JeffB-BE/Morse-CPO/README.md

# Morse-CPO
Twin-T Oscillator design based upon the work by Michael A. Maynard (K4ICY).
