JeffB-BE/Morse-CPO/KiCad/Twin-T_Code_Practice_Oscillator/img/Twin-T_Code_Practice_Oscillator_PCB-1.png

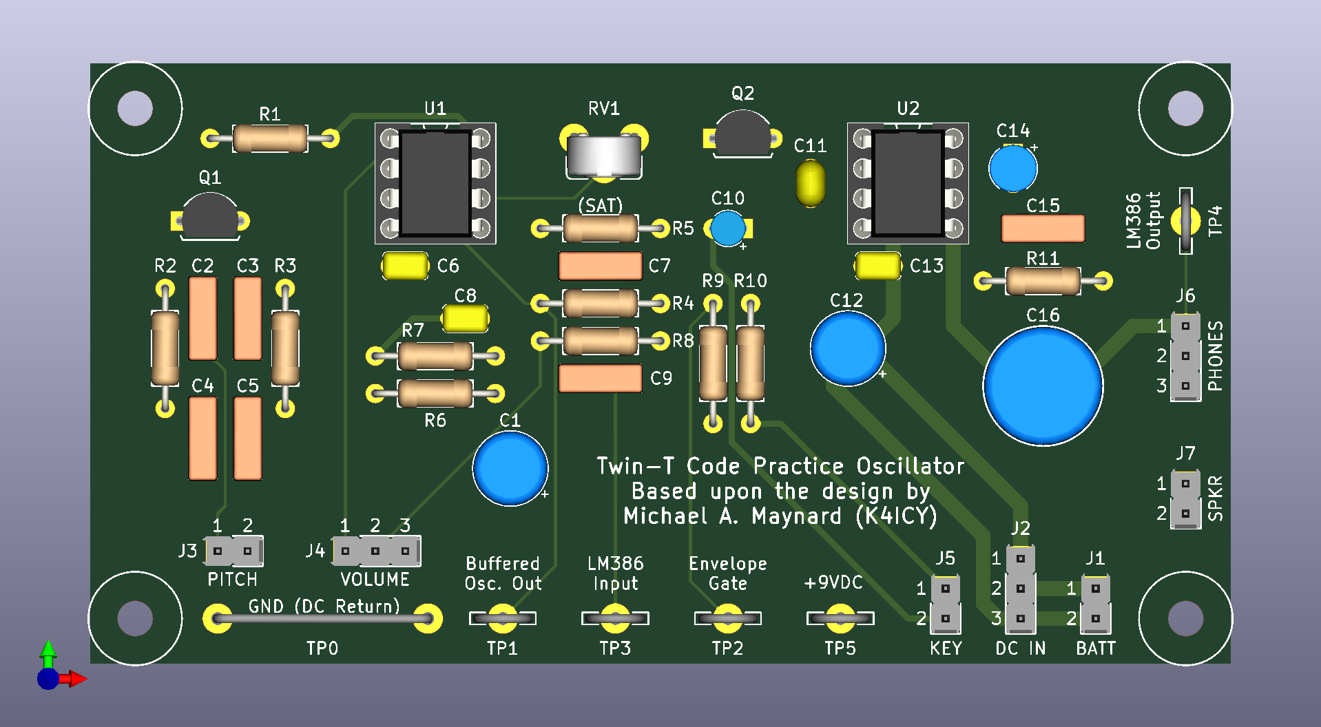
KiCad/Twin-T_Code_Practice_Oscillator/img/Twin-T_Code_Practice_Oscillator_PCB-1.png
