JeffB-BE/Morse-CPO/Twin-T_Code_Practice_Oscillator_Rev(A)_SystemBOM.xlsx

Sheet: PCB
Item | Qty | References | Value | Lead Spacing | Type | Mfrg. | Manufacturer P/N | Distributor | Dist. P/N | Status | Datasheet
1 | 1 | C11 | 47p | 100mil (2.5mm) | MLCC, C0G | Vishay-Sprague | 1C10C0G470J050B | Mouser | 75-1C10C0G470J050B |  | https://www.mouser.com/datasheet/2/427/Sprague%201C-3C%20MLC%20leaded%20capacitors%202000-1211470.pdf
2 | 3 | C6, C8, C13 | 100n | 100mil (2.5mm) | MLCC, X7R | Vishay | K103K15X7RF53L2 | Mouser | 594-K103K15X7RF53L2 |  | https://www.vishay.com/docs/45171/kseries.pdf
3 | 4 | C2, C3, C4, C5 | 10n | 200 mil (5mm) | Polyester Film | Kemet | MMK5103J63J01L16.5 | Mouser | 80-MMK5103J63J01TR18 |  | https://content.kemet.com/datasheets/F3294_MMK.pdf
4 | 1 | C7 | 47n | 200 mil (5mm) | Polyester Film | Kemet | MMK5473J63J01L4 | Mouser | 80-MMK5473J63J01L4 |  | https://content.kemet.com/datasheets/F3294_MMK.pdf
5 | 1 | C9 | 15n | 200 mil (5mm) | Polyester Film | Kemet | MMK5153J63J01L16.5 | Mouser | 80-MMK5153J63J01TR16 |  | https://content.kemet.com/datasheets/F3294_MMK.pdf
6 | 1 | C15 | 100n | 200 mil (5mm) | Polyester Film | Kemet | MMK5104J63J01L4 | Mouser | 80-MMK5104J63J01L4 |  | https://content.kemet.com/datasheets/F3294_MMK.pdf
7 | 1 | C16 | 220u | 200 mil (5mm) | Non-Polarized Electrolytic | Panasonic | ECE-A1CN221XB | Mouser | 667-ECE-A1CN221XB |  | https://industrial.panasonic.com/cdbs/www-data/pdf/RDF0000/ABA0000C1053.pdf
8 | 1 | C10 | 4u7 | 100mil (2.5mm) | Electrolytic | Nichicon | UMA1C4R7MCD2TP | Mouser | 647-UMA1C4R7MCD2TP |  | https://www.nichicon.co.jp/english/products/pdfs/e-uma.pdf
9 | 1 | C14 | 10u | 100mil (2.5mm) | Electrolytic | Nichicon | UMA1C100MDD | Mouser | 647-UMA1C100MDD |  | https://www.nichicon.co.jp/english/products/pdfs/e-uma.pdf
10 | 2 | C1, C12 | 220u | 100mil (2.5mm) | Electrolytic | Panasonic | EEU-FR1C221 | Mouser | 667-EEU-FR1C221 |  | https://industrial.panasonic.com/cdbs/www-data/pdf/RDF0000/ABA0000C1259.pdf
11 | 2 | R2, R3 | 33k | (Axial) | Metal Film, 1/4W 1% | Yageo | MFR-25FBF52-33K | Mouser | 603-MFR-25FBF52-33K |  | https://www.yageo.com/upload/media/product/products/datasheet/lr/Yageo_LR_MFR_1.pdf
12 | 2 | R6, R7 | 10k | (Axial) | Metal Film, 1/4W 1% | Yageo | MFR-25FBF52-10K | Mouser | 603-MFR-25FBF52-10K |  | https://www.yageo.com/upload/media/product/products/datasheet/lr/Yageo_LR_MFR_1.pdf
13 | 1 | R1 | 100k | (Axial) | Metal Film, 1/4W 1% | Yageo | MFR-25FBF52-100K | Mouser | 603-MFR-25FBF52-100K |  | https://www.yageo.com/upload/media/product/products/datasheet/lr/Yageo_LR_MFR_1.pdf
14 | 1 | R4 | 49R9 | (Axial) | Metal Film, 1/4W 1% | Yageo | MFR-25FBF52-49R9 | Mouser | 603-MFR-25FBF52-49R9 |  | https://www.yageo.com/upload/media/product/products/datasheet/lr/Yageo_LR_MFR_1.pdf
15 | 1 | R5 | 4k7 | (Axial) | Metal Film, 1/4W 1% | Yageo | MFR-25FBF52-4k7 | Mouser | 603-MFR-25FBF52-4K7 |  | https://www.yageo.com/upload/media/product/products/datasheet/lr/Yageo_LR_MFR_1.pdf
16 | 1 | R8 | 100R | (Axial) | Metal Film, 1/4W 1% | Yageo | MFR-25FBF52-100R | Mouser | 603-MFR-25FBF52-100R |  | https://www.yageo.com/upload/media/product/products/datasheet/lr/Yageo_LR_MFR_1.pdf
17 | 1 | R9 | 24k9 | (Axial) | Metal Film, 1/4W 1% | Yageo | MFR-25FBF52-24k9 | Mouser | 603-MFR-25FBF52-24K9 |  | https://www.yageo.com/upload/media/product/products/datasheet/lr/Yageo_LR_MFR_1.pdf
18 | 1 | R10 | 3k3 | (Axial) | Metal Film, 1/4W 1% | Yageo | MFR-25FBF52-3K3 | Mouser | 603-MFR-25FBF52-3K3 |  | https://www.yageo.com/upload/media/product/products/datasheet/lr/Yageo_LR_MFR_1.pdf
19 | 1 | R11 | 10R | (Axial) | Metal Film, 1/4W 1% | Yageo | MFR-25FBF52-10R | Mouser | 603-MFR-25FBF52-10R |  | https://www.yageo.com/upload/media/product/products/datasheet/lr/Yageo_LR_MFR_1.pdf
20 | 1 | U1 | TLV272 | DIP-8 | Dual Op-Amp | TI | TLV272IP | Mouser | 595-TLV272IP |  | https://www.ti.com/lit/ds/symlink/tlv272.pdf
21 | 1 | U2 | LM386 | DIP-8 | Audio Amplifier | TI | LM386MX-1/NOPB | Mouser | 926-LM386MX-1/NOPB |  | https://www.ti.com/lit/ds/symlink/lm386.pdf
22 | 1 | TP0 | 20AWG Bar 700mil | 700mil (18mm) | Hand-made from 20AWG (0.8mm) solid wire | (custom) | - | - | - |  | -
23 | 5 | TP1, TP2, TP3, TP4, TP5 | 20AWG Loop | (single lead) | Hand-made from 20AWG (0.8mm) solid wire | (custom) | - | - | - |  | -
24 | 1 | RV1 | 10k | 100x100mil (2.5mm) | Single-turn vertical trimpot | Amphenol Piher | PT6KH-103A2020 | Mouser | 531-PT6KH-10K |  | https://www.mouser.com/datasheet/2/18/11-PT6v03-1499160.pdf
25 | 1 | Q1 | PN2222A | TO-92 100mil (2.5mm) | BJT, NPN | Fairchild | PN2222ATA | Mouser | 512-PN2222ATA |  | http://www.fairchildsemi.com/ds/PN/PN2222A.pdf
26 | 1 | Q2 | 2N7000 | TO-92 100mil (2.5mm) | MOSFET, N-Channel | Fairchild | 2N7000 | Mouser | 512-2N7000 |  | https://www.fairchildsemi.com/datasheets/2N/2N7000.pdf
27 | 1 | J1, J3, J5, J7 |  | 100mil (2.5mm) | Header, unshrouded, SIP, 2-position | Molex | 22-28-4020 | Mouser | 538-22-28-4020 |  | https://www.molex.com/pdm_docs/sd/022284364_sd.pdf
28 | 1 | J2, J4, J6 |  | 100mil (2.5mm) | Header, unshrouded, SIP, 3-position | Molex | 22-28-4030 | Mouser | 538-22-28-4030 |  | https://www.molex.com/pdm_docs/sd/022284364_sd.pdf

Sheet: Enclosure
Item | Qty. | U/M | Description | Manufacturer | Mfrg. P/N | Dist. | Dist. P/N | Status | Notes
1 | 1 | ea. | Enclosure | Hammond | 1456CE3WHBU | DigiKey | HM3090-ND (https://www.digikey.com/product-detail/en/hammond-manufacturing/1456CE3WHBU/HM3090-ND/460195)
2 | 1 | ea. | Speaker, 8 Ohm, 87mm | CUI | GF0778B | Mouser | 490-GF0778B (https://www.mouser.com/ProductDetail/CUI-Devices/GF0778B)
3 | 1 | ea. | Potentiometer, 10k Ohms, Linear Taper, with Switch, 6mm dia Shaft | CTS | 450T328S103A1C1 | DigiKey | CT3047-ND (https://www.digikey.com/product-detail/en/cts-electrocomponents/450T328S103A1C1/CT3047-ND/4733097) |  | Volume control and power
4 | 1 | ea. | Potentiometer, 10k Ohms, Reverse Logrithmic Taper, 6mm dia Shaft | TT Electronics | P160KNP-0FC25C10K | DigiKey | 987-1729-ND (https://www.digikey.com/product-detail/en/tt-electronics-bi/P160KNP-0FC25C10K/987-1729-ND/5957473) |  | Pitch control
5 | 1 | ea. | Knob, 6mm, Skirted with Numbers 1-10 | Kilo | SC-50-4-7 | DigiKey | 226-4080-ND (https://www.digikey.com/product-detail/en/kilo-international/SC-50-4-7/226-4080-ND/710602) |  | For Item 3 (Volume)
6 | 1 | ea. | Knob, 6mm, Skirted with Pointer | Kilo | DDS-50-4-7 | DigiKey | 226-4023-ND (https://www.digikey.com/product-detail/en/kilo-international/DDS-50-4-7/226-4023-ND/305212) |  | For Item 4 (Pitch)
7 | 1 | ea. | Battery Box with slide-out tray, 9V | Bulgin | BX0023 | DigiKey | 708-1403-ND (https://www.digikey.com/product-detail/en/bulgin/BX0023/708-1403-ND/1980761)
8 | 1 | ea. | Jack, DC Coaxial, Switched, 5.5x2.5mm, Bulkhead Mount, Front Nut | Switchcraft | 712A | Mouser | 502-712A (https://www.mouser.com/ProductDetail/502-712A)
9 | 1 | ea. | AC-DC Power Supply, Wall Wart, 5.5x2.5mm Plug | Triad Magnetics | WSU090-0800-13 | Mouser | 553-WSU090-0800-13 (https://www.mouser.com/ProductDetail/Triad-Magnetics/WSU090-0800-13) |  | (OPTIONAL) For use with Item 8
10 | 1 | ea. | Jack, 1/4 inch, TS, Unswitched, Bulkhead Mount | Switchcraft | 11 | DigiKey | SC1085-ND (https://www.digikey.com/product-detail/en/switchcraft-inc/11/SC1085-ND/109515) |  | Jack for Morse Key
11 | 1 | ea. | Jack, 1/4 inch, TRS, Switched, Bulkhead Mount | Switchcraft | 14B | DigiKey | SC1099-ND (https://www.digikey.com/product-detail/en/switchcraft-inc/14B/SC1099-ND/109556) |  | Jack for Headphones
12 | 1 | ea. | PCB Assembly, Twin-T CPO | (Custom) | - | - | - |  | See KiCAD design files for this project: github.com/JeffB-BE/Morse-CPO
13 | 4 | ea. | Screw, Phillips, Flat Head, #6-32 x 1/2 inch | (any) | - | - | - |  | For mounting Item 2 (Speaker)
14 | 4 | ea. | Washer, Flat, Regular, #6 | (any) | - | - | - |  | For mounting Item 2 (Speaker)
15 | 4 | ea. | Nut, Hex, Nylon Locking, #6-32 | (any) | - | - | - |  | For mounting Item 2 (Speaker)
16 | 4 | ea. | Screw, Phillips, Flat Head, #4-40 x 3/4 inch | (any) | - | - | - |  | For mounting Item 12 (PCB)
17 | 4 | ea. | Nut, Hex, Machine, #4-40 | (any) | - | - | - |  | For mounting Item 12 (PCB)
18 | 4 | ea. | Spacer, Round, Aluminum, 120mil ID, 250mil OD, 250mil L | Keystone | 3457 | - | - |  | For mounting Item 12 (PCB)
19 | 8 | ea. | Washer, Flat, Regular, #4 | (any) | - | - | - |  | For mounting Item 12 (PCB) and Item 7 (Battery Box)
20 | 6 | ea. | Nut, Hex, Nylon Locking, #4-40 | (any) | - | - | - |  | For mounting Item 12 (PCB) and Item 7 (Battery Box)
21 | 2 | ea. | Screw, Phillips, Flat Head, #4-40 x 1/2 inch | (any) | - | - | - |  | For mounting Item 7 (Battery Box)
22 | 2 | ft. | Wire, Multiconductor, Jacketed and Shielded, 1 Pair, 26AWG or 28AWG | (any) | - | Markertek | 2697 (https://www.markertek.com/product/2697/mogami-w2697-miniature-balanced-cable-black-per-foot) |  | For wiring the front potentiometers to the PCB. (cable example: Mogami 2697)
23 | A/R | ft. | Wire, Single Conductor, Insulated, Stranded, 22 AWG | (any) | - | - | - |  | For wiring the Speaker, Battery and DC Input Jacks to the PCB.
24 | A/R | ft. | Wire, Single Conductor, Insulated, Stranded, 26 AWG | (any) | - | - | - |  | For wiring the Key and Headphone Jacks to the PCB.
25 | 4 | ea. | Conn, Wire Housing, Receptacle, Free-Hanging, Non-Polarized, 2-Position | Molex | 50-57-9002 | Mouser | 538-50-57-9002 (https://www.mouser.com/ProductDetail/Molex/50-57-9002) |  | Wire-to-PCB (J1/J3/J5/J7)
26 | 3 | ea. | Conn, Wire Housing, Receptacle, Free-Hanging, Non-Polarized, 3-Position | Molex | 50-57-9003 | Mouser | 538-50-57-9003 (https://www.mouser.com/ProductDetail/Molex/50-57-9003) |  | Wire-to-PCB (J2/J4/J6)
27 | 7 | ea. | Contact, Socket, Crimp, 22-24 AWG, Gold Plated, High-Force | Molex | 16-02-1111 | DigiKey | WM2570CT-ND (https://www.digikey.com/product-detail/en/molex/0016021111/WM2570CT-ND/1656211) |  | For wiring J1/J2/J7 (Battery, DC In, Speaker)
28 | 10 | ea. | Contact, Socket, Crimp, 24-30 AWG, Gold Plated, High-Force | Molex | 16-02-1113 | DigiKey | WM2572CT-ND (https://www.digikey.com/product-detail/en/molex/0016021113/WM2572CT-ND/1656213) |  | For wiring J3-J6 (Key Jack, Phones Jack, Pitch Pot, Volume Pot)
