JeffB-BE/Morse-CPO/Twin-T_Code_Practice_Oscillator_Rev(A)_OverviewDocs.pdf

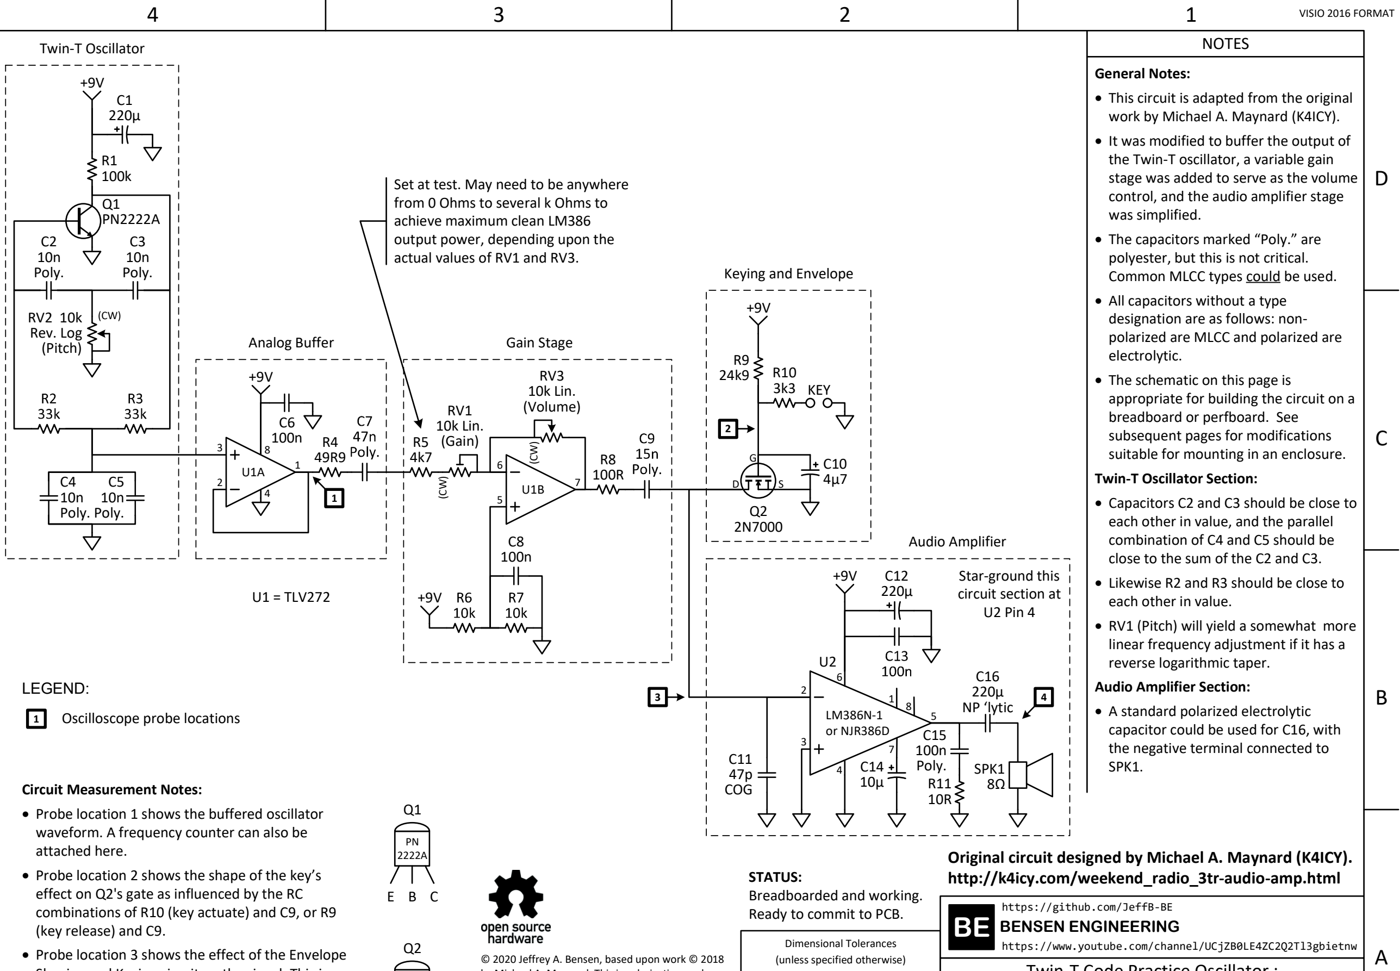
[picture p4: figure]
VISIO 2016 FORMAT; NOTES; Dimensional Tolerances; (unless specified otherwise); BENSEN ENGINEERING; https://github.com/JeffB-BE; https://www.youtube.com/channel/UCjZB0LE4ZC2Q2Tl3gbietnw; General Notes:; work by Michael A. Maynard (K4ICY).; the Twin-T oscillator, a variable gain stage was added to serve as the volume control, and the audio amplifier stage was simplified. • The capacitors marked “Poly.” are; polyester, but this is not critical. Common MLCC types could be used. • All capacitors without a type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

A

4 | 3 | 2 | 1

D

C

B

A

VISIO 2016 FORMAT

2 3
Places | Places | Angles
±0.010 | ±0.005 | ±1 Deg

### Twin-T Code Practice Oscillator : Schematic

SIZE | DWG NO | REV
A

A

SCALE | NONE | SHEET | 1 OF 6
ISSUED | 2020-09-02
DRAWN BY | J. BENSEN
- This circuit is adapted from the original
- It was modified to buffer the output of

appropriate for building the circuit on a

- Capacitors C2 and C3 should be close to
- RV1 (Pitch) will yield a somewhat more

Original circuit designed by Michael A. Maynard (K4ICY).

Documentation licensed under CC BY-SA 4.0

© 2020 Jeffrey A. Bensen, based upon work © 2018 by Michael A. Maynard. This is a derivative work and is not endorsed by Michael A. Maynard.

Hardware design licensed under CERN-OHL-S v2

- Probe location 1 shows the buffered oscillator

waveform. A frequency counter can also be

- Probe location 2 shows the shape of the key’s

effect on Q2's gate as influenced by the RC combinations of R10 (key actuate) and C9, or R9

- Probe location 3 shows the effect of the Envelope

Shaping and Keying circuit on the signal. This is also the input signal to the audio amplifier.
- Measuring the AC RMS levels of probe locations 3

and 4 allows calculation of amplifier gain.

2N
7000

S G D

D

D

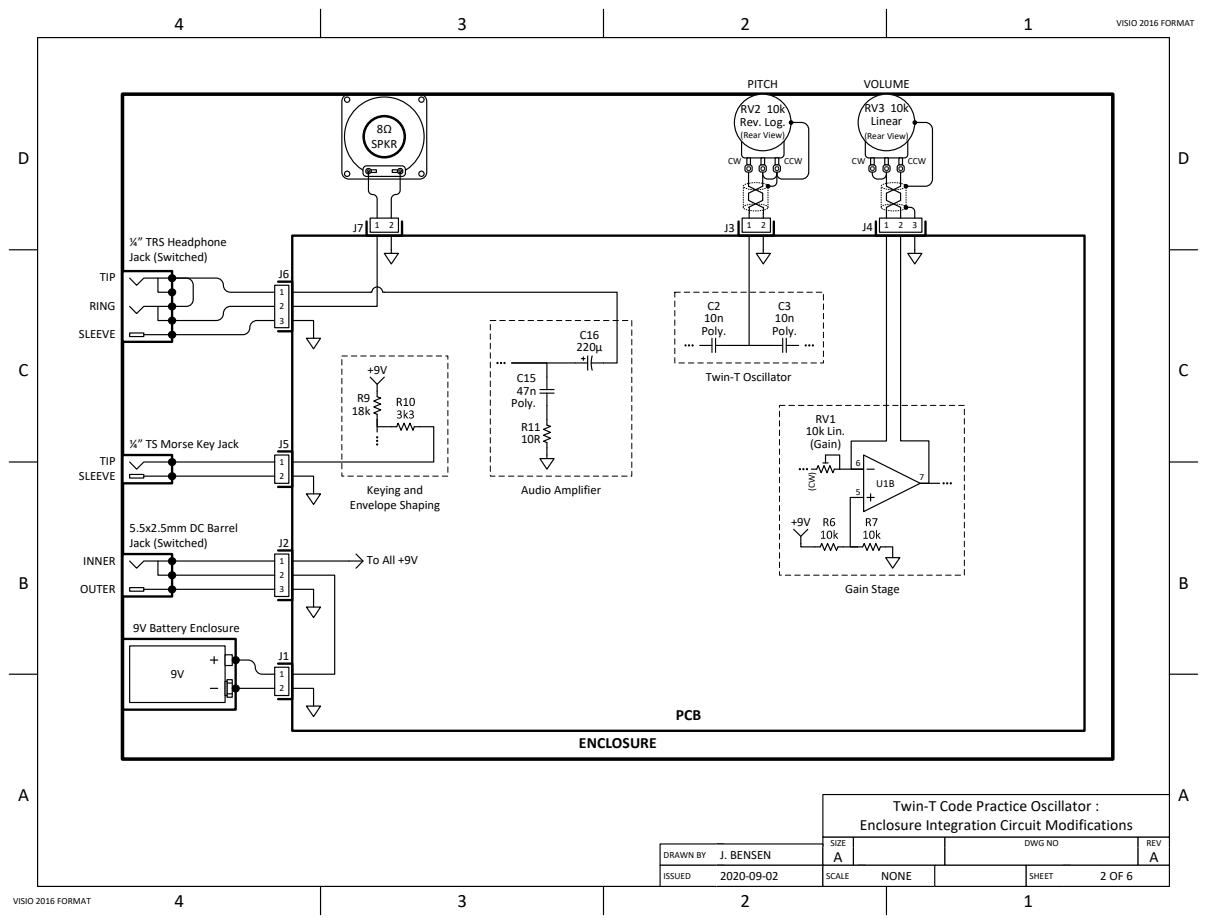
[picture p5: page 2]

¼” TS Morse Key Jack
TIP
SLEEVE

Twin-T Code Practice Oscillator :
Enclosure Integration Circuit Modifications

D

D

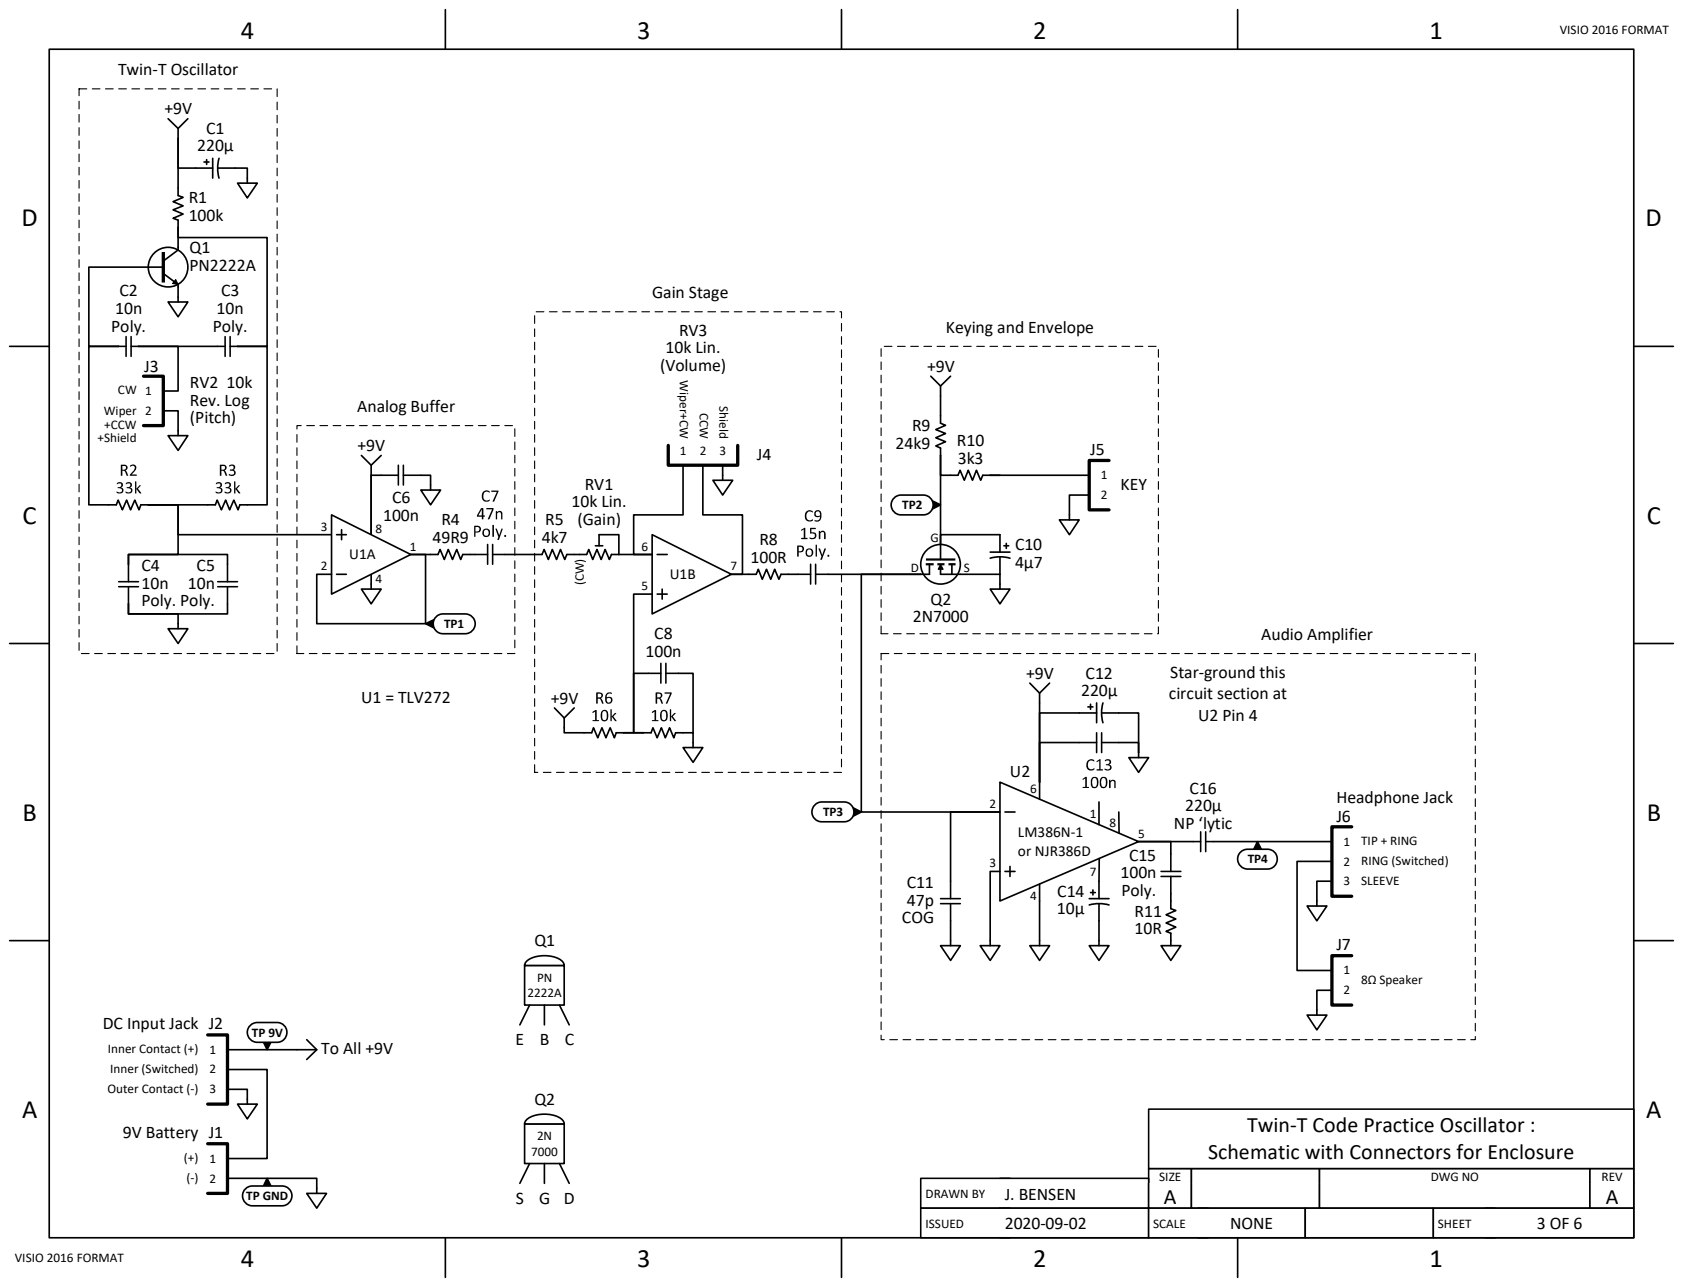
[picture p6: page 3]

Twin-T Code Practice Oscillator :
Schematic with Connectors for Enclosure

D

D

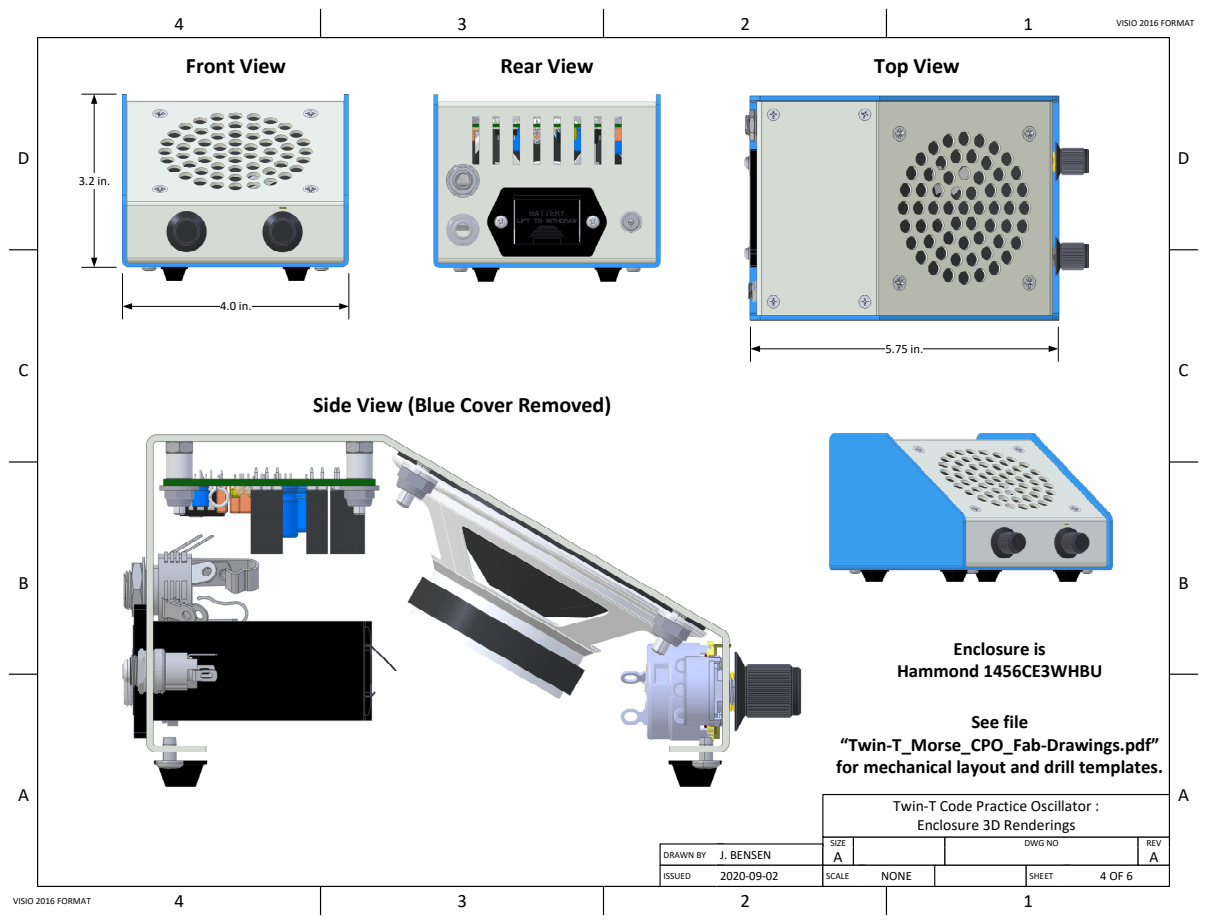
[picture p7: page 4]
SIZE; DWG NO; REV; DRAWN BY; J. BENSEN; ISSUED; SCALE; NONE; SHEET; Front View; Rear View; Top View; Enclosure is Hammond 1456CE3WHBU; See file

Side View (Blue Cover Removed)

“Twin-T_Morse_CPO_Fab-Drawings.pdf”
for mechanical layout and drill templates.

Twin-T Code Practice Oscillator :
Enclosure 3D Renderings

D

D

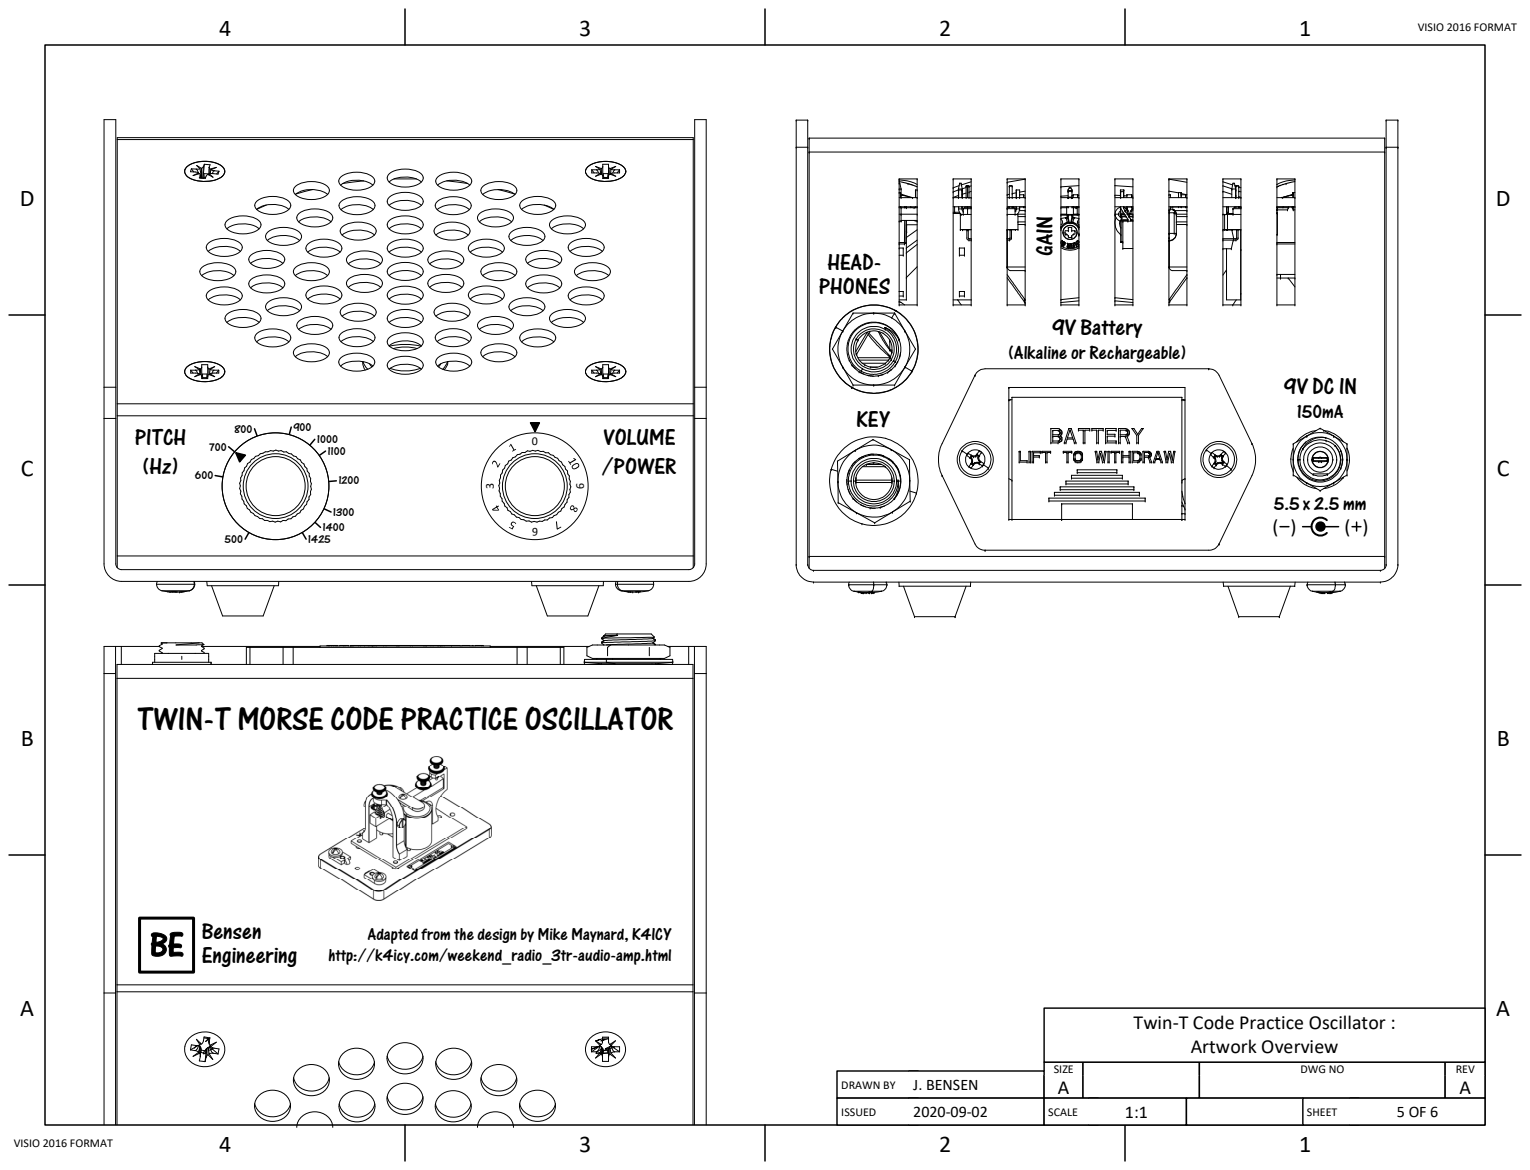
[picture p8: page 5]
SIZE; DWG NO; REV; DRAWN BY; J. BENSEN; ISSUED; SCALE; NONE; SHEET; Artwork Overview; HEAD- PHONES; KEY; Adapted from the design by Mike Maynard, K4ICY BE; http://k4icy.com/weekend_radio_3tr-audio-amp.html Bensen Engineering; GAIN; VOLUME /POWER; PITCH (Hz)

9V Battery
(Alkaline or Rechargeable)

TWIN-T MORSE CODE PRACTICE OSCILLATOR

Twin-T Code Practice Oscillator :

D

D

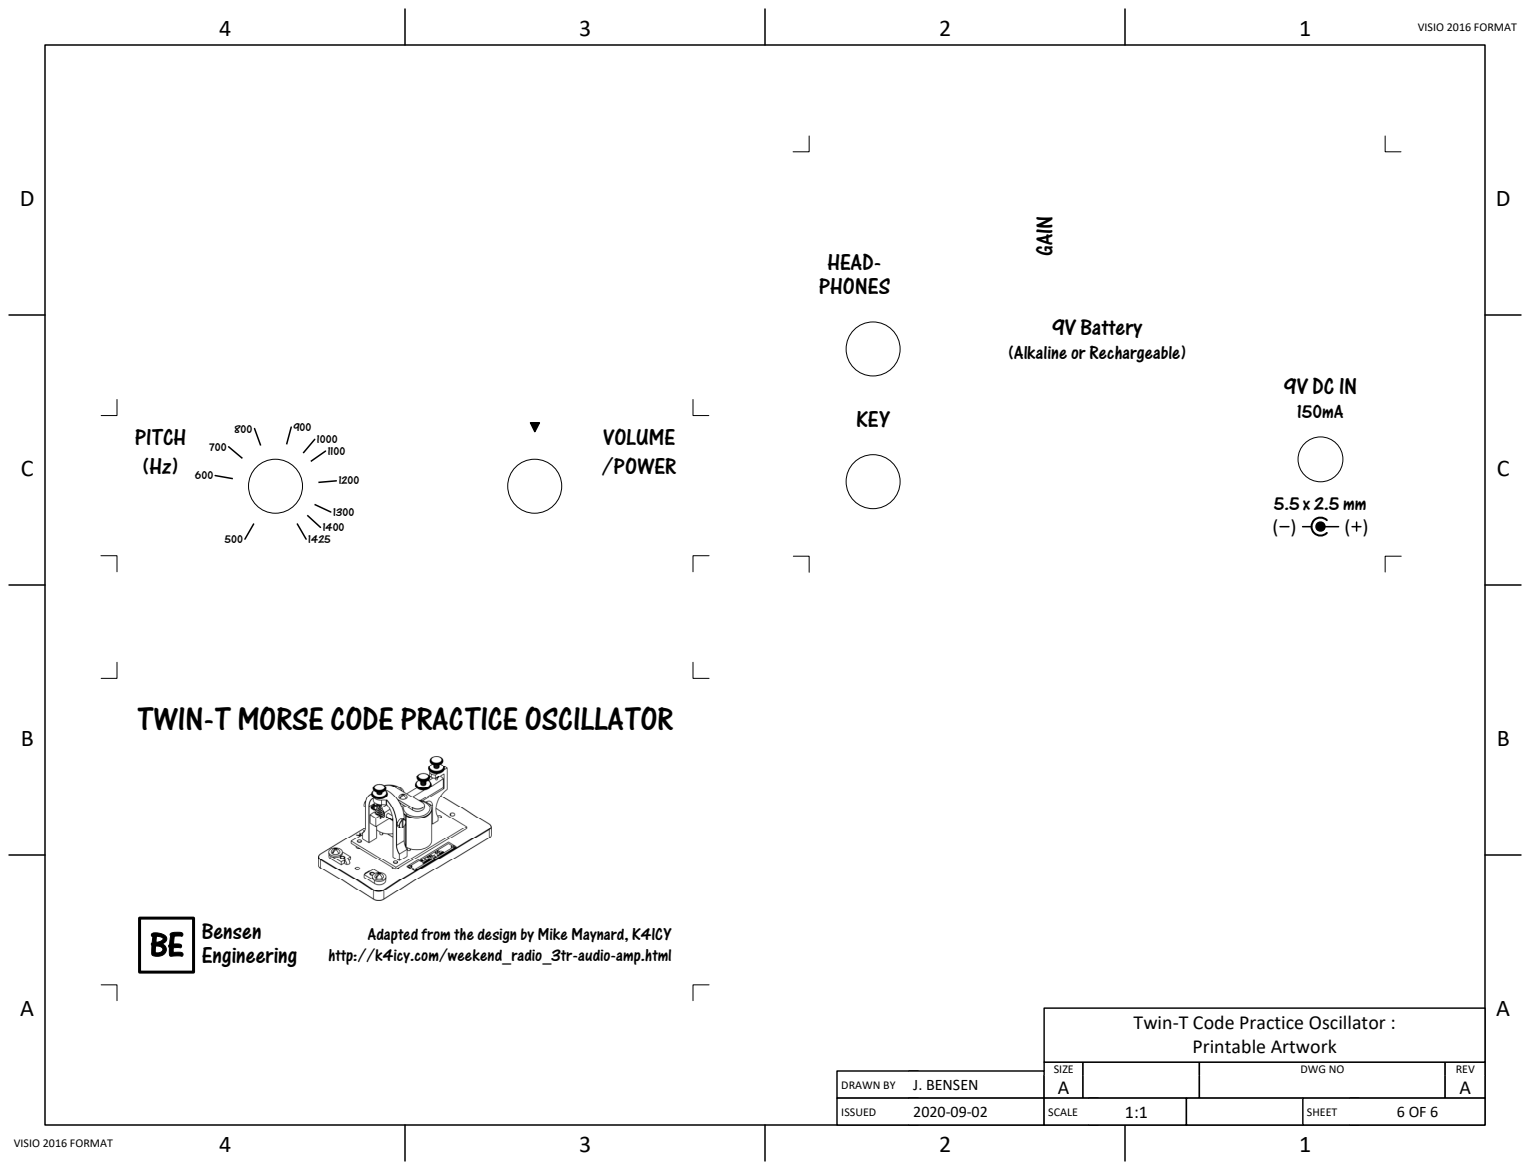
[picture p9: page 6]
SIZE; DWG NO; REV; DRAWN BY; J. BENSEN; ISSUED; SCALE; NONE; SHEET; Printable Artwork; HEAD- PHONES; KEY; Adapted from the design by Mike Maynard, K4ICY BE; http://k4icy.com/weekend_radio_3tr-audio-amp.html Bensen Engineering; GAIN; VOLUME /POWER; PITCH (Hz)

9V Battery
(Alkaline or Rechargeable)

TWIN-T MORSE CODE PRACTICE OSCILLATOR

Twin-T Code Practice Oscillator :
