JeffB-BE/Morse-CPO/Mechanical/Morse_CPO_Enclosure_Fab Drawing_Rev(A).pdf

## FABRICATION DRAWING

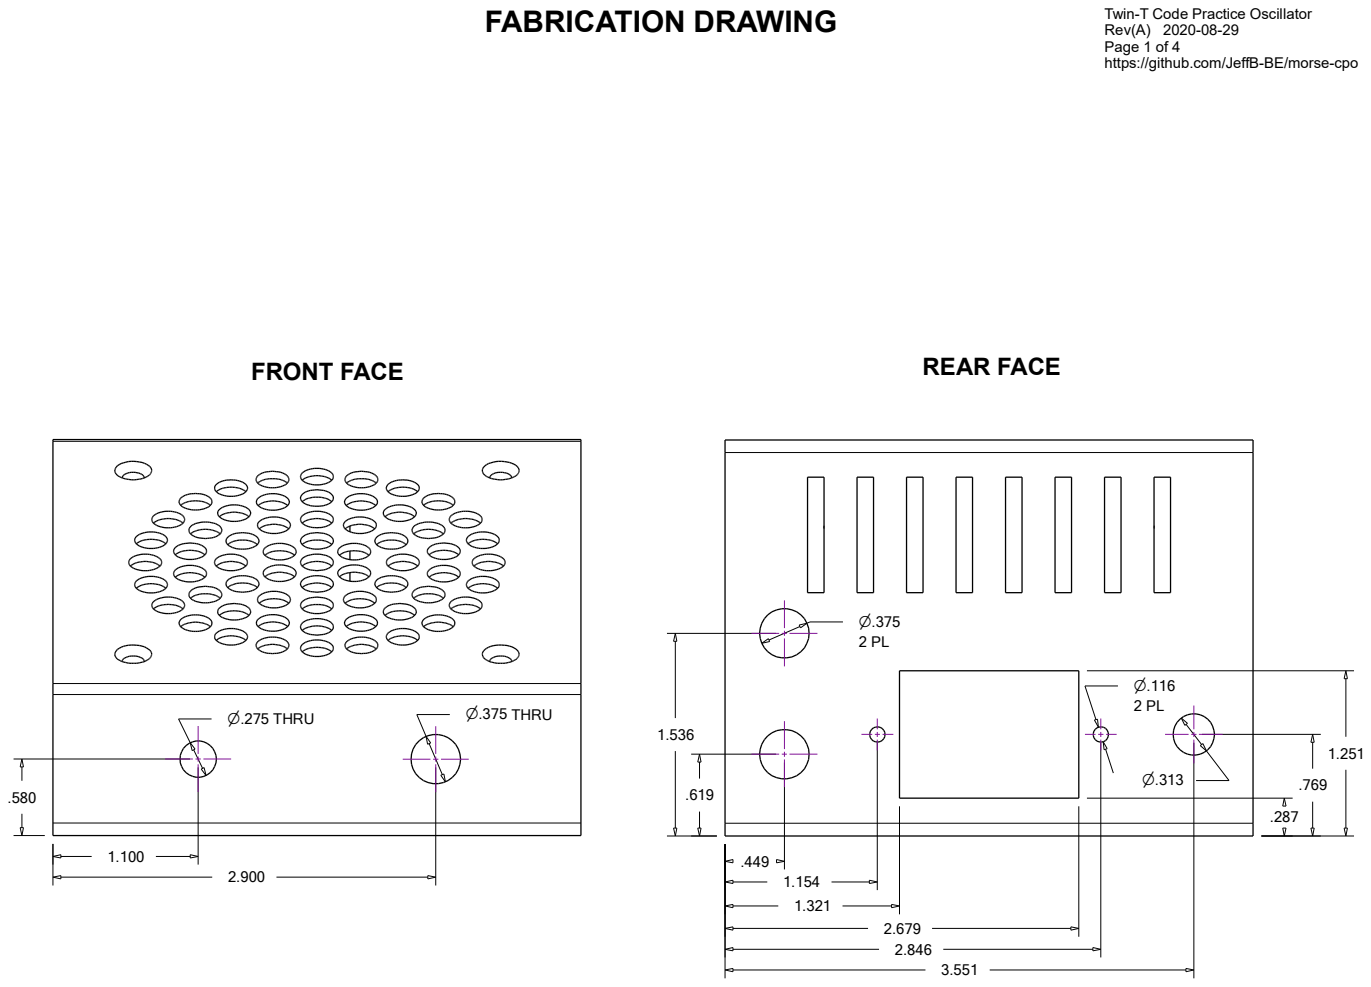
[picture p10: page 1]
2 PL n.275 THRU; n.375 THRU; FRONT FACE; REAR FACE

Twin-T Code Practice Oscillator
Rev(A) 2020-08-29

https://github.com/JeffB-BE/morse-cpo

## FABRICATION DRAWING

### TOP FACE

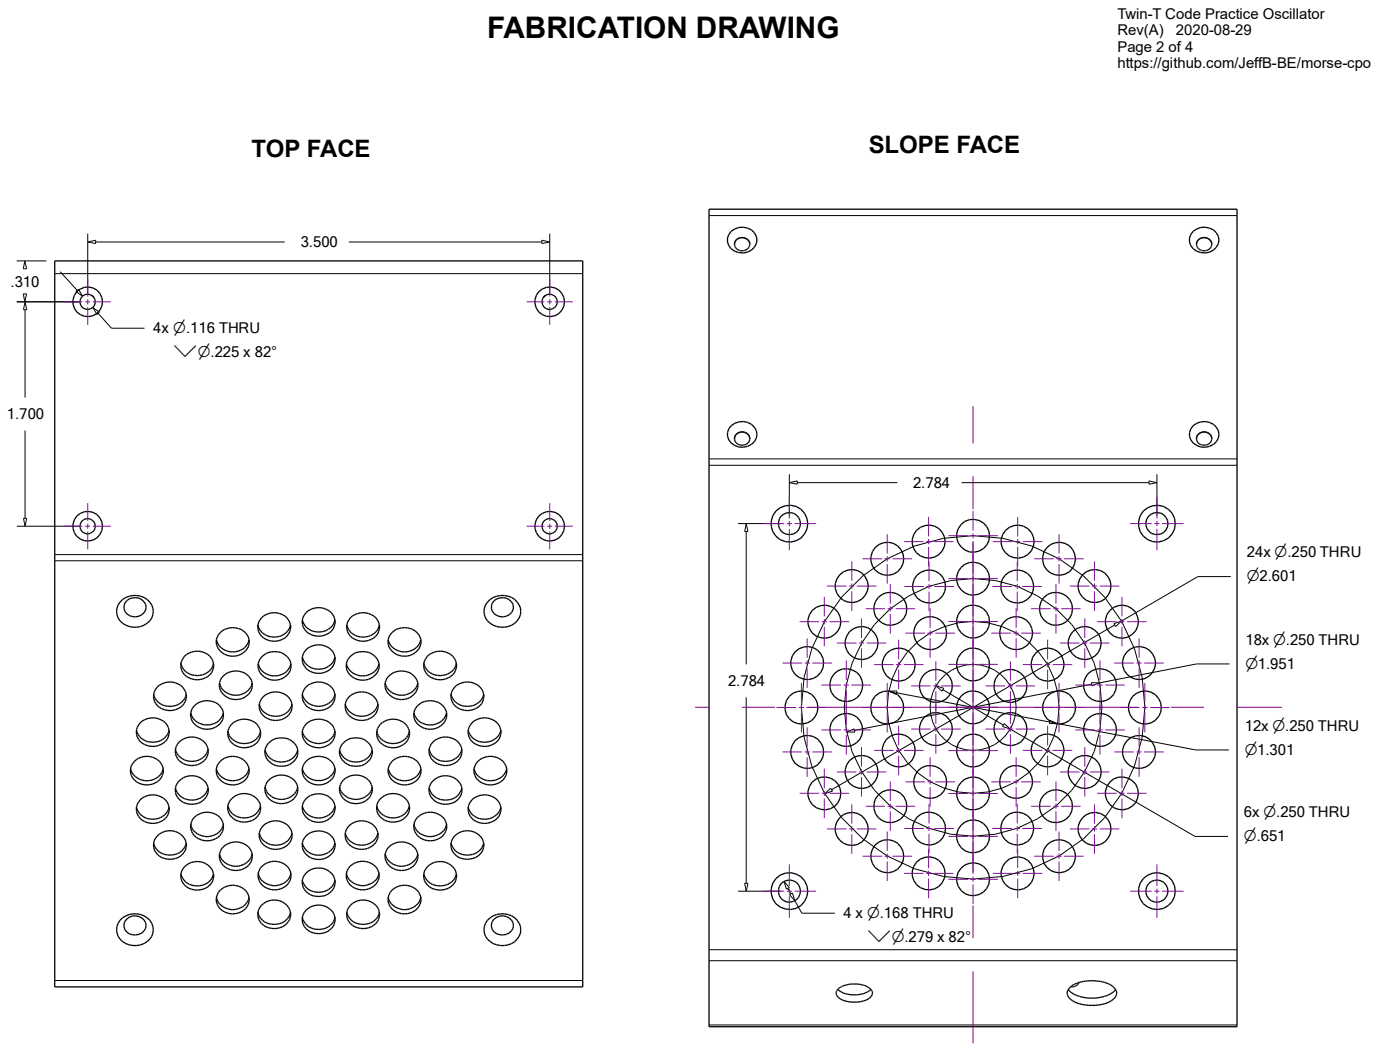
[picture p11: page 2]
THRU; 6x n.250 THRU; 12x n.250 THRU; 24x n.250 THRU; 18x n.250 THRU; SLOPE FACE

https://github.com/JeffB-BE/morse-cpo

## DRILL TEMPLATES

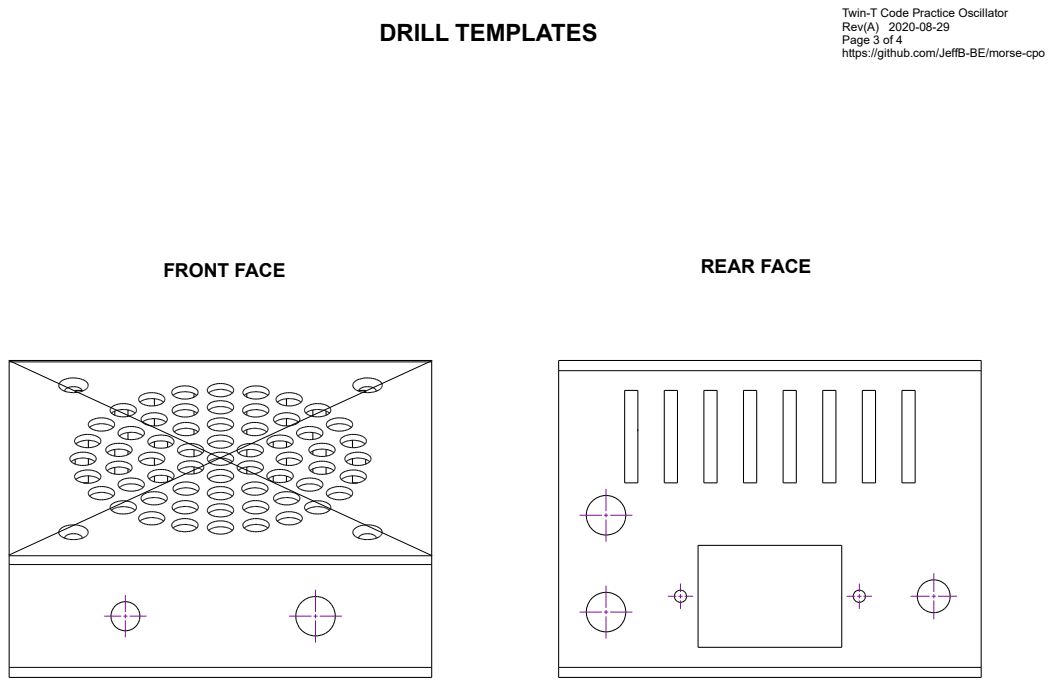
[picture p12: page 3]
FRONT FACE; REAR FACE

https://github.com/JeffB-BE/morse-cpo

## DRILL TEMPLATES

TOP FACE | SLOPE FACE

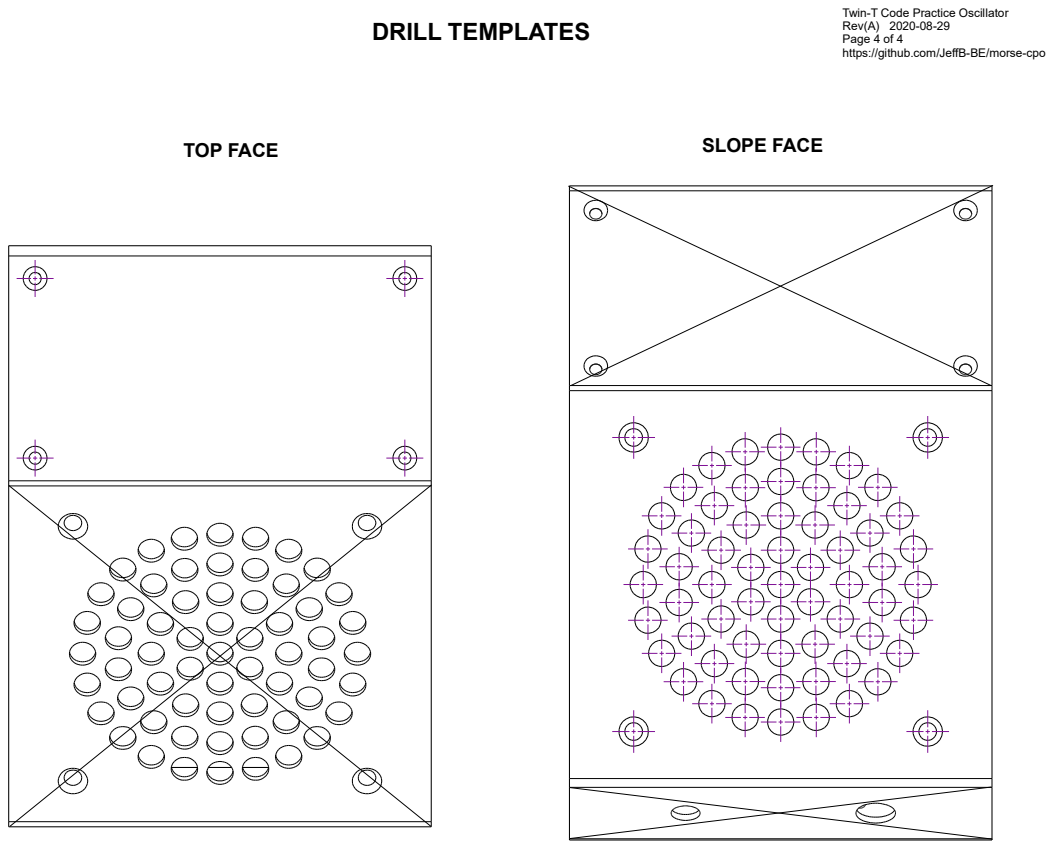
[picture p13: page 4]

https://github.com/JeffB-BE/morse-cpo
