JeffB-BE/Morse-CPO/KiCad/Twin-T_Code_Practice_Oscillator/Twin-T_Code_Practice_Oscillator_Schematic.pdf

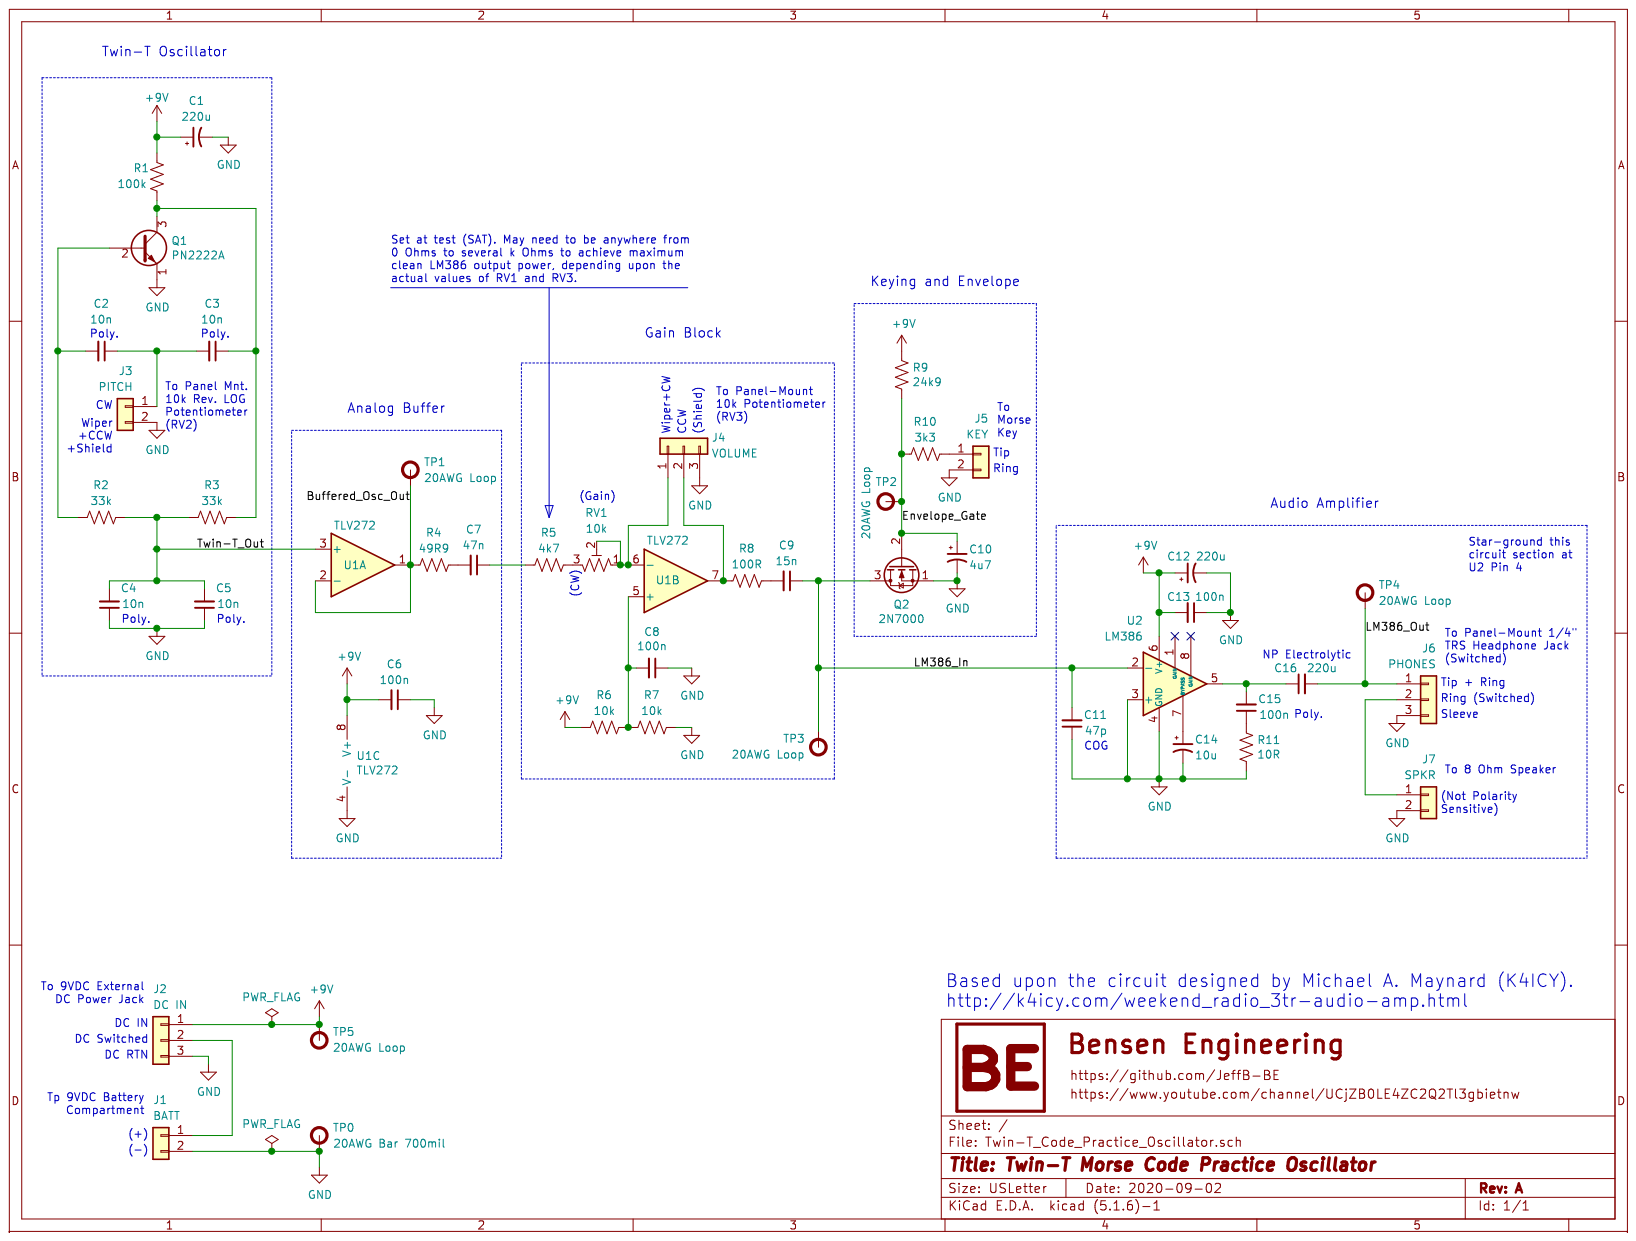
[picture p14: page 1]
