JeffB-BE/Morse-CPO/KiCad/Twin-T_Code_Practice_Oscillator/Twin-T_Code_Practice_Oscillator_FabDwg.pdf

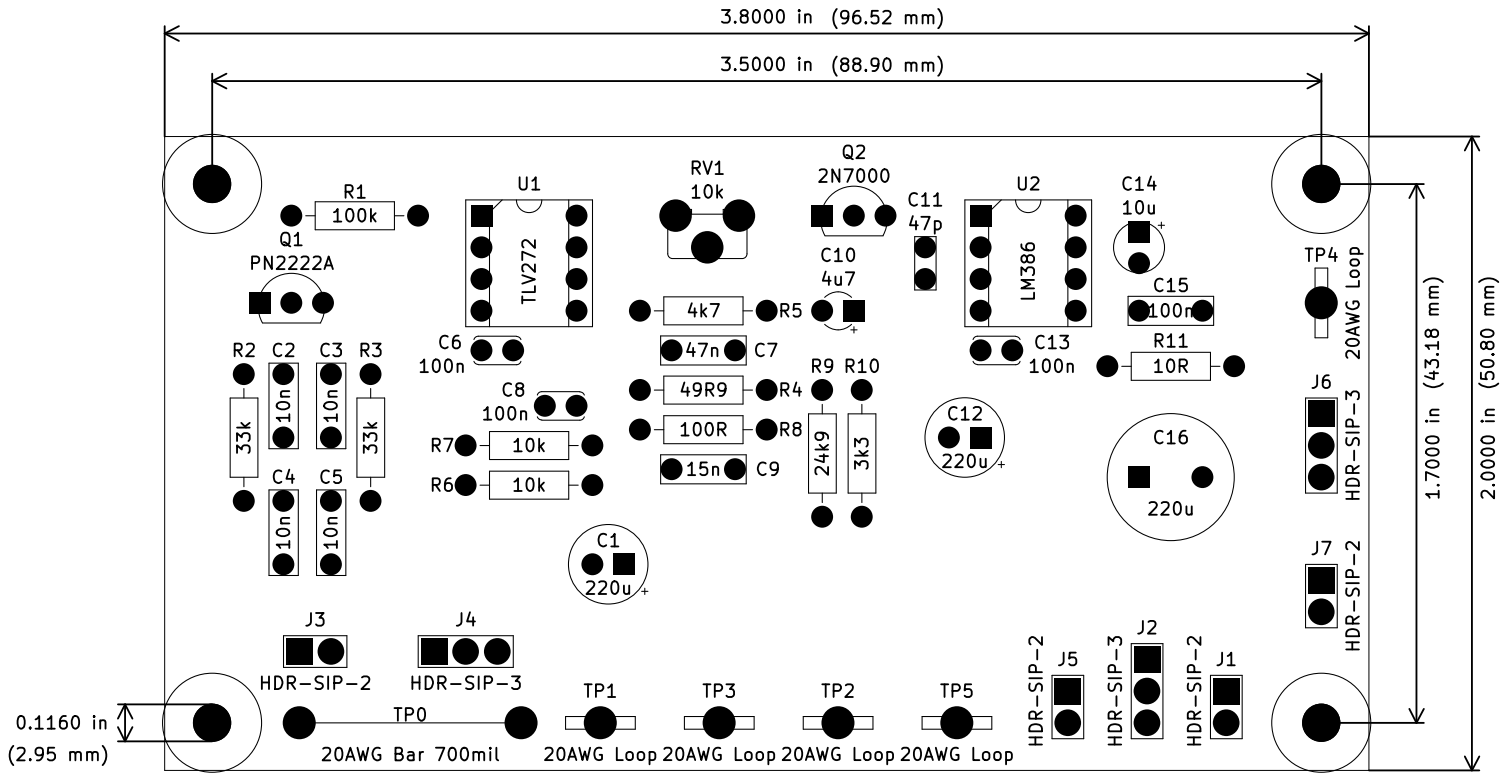
[picture p15: page 1]
