JeffB-BE/Morse-CPO/KiCad/Twin-T_Code_Practice_Oscillator/Twin-T_Code_Practice_Oscillator.kicad_pcb

## KiCad design KiCad/Twin-T_Code_Practice_Oscillator/Twin-T_Code_Practice_Oscillator.kicad_pcb (2020-09-02)

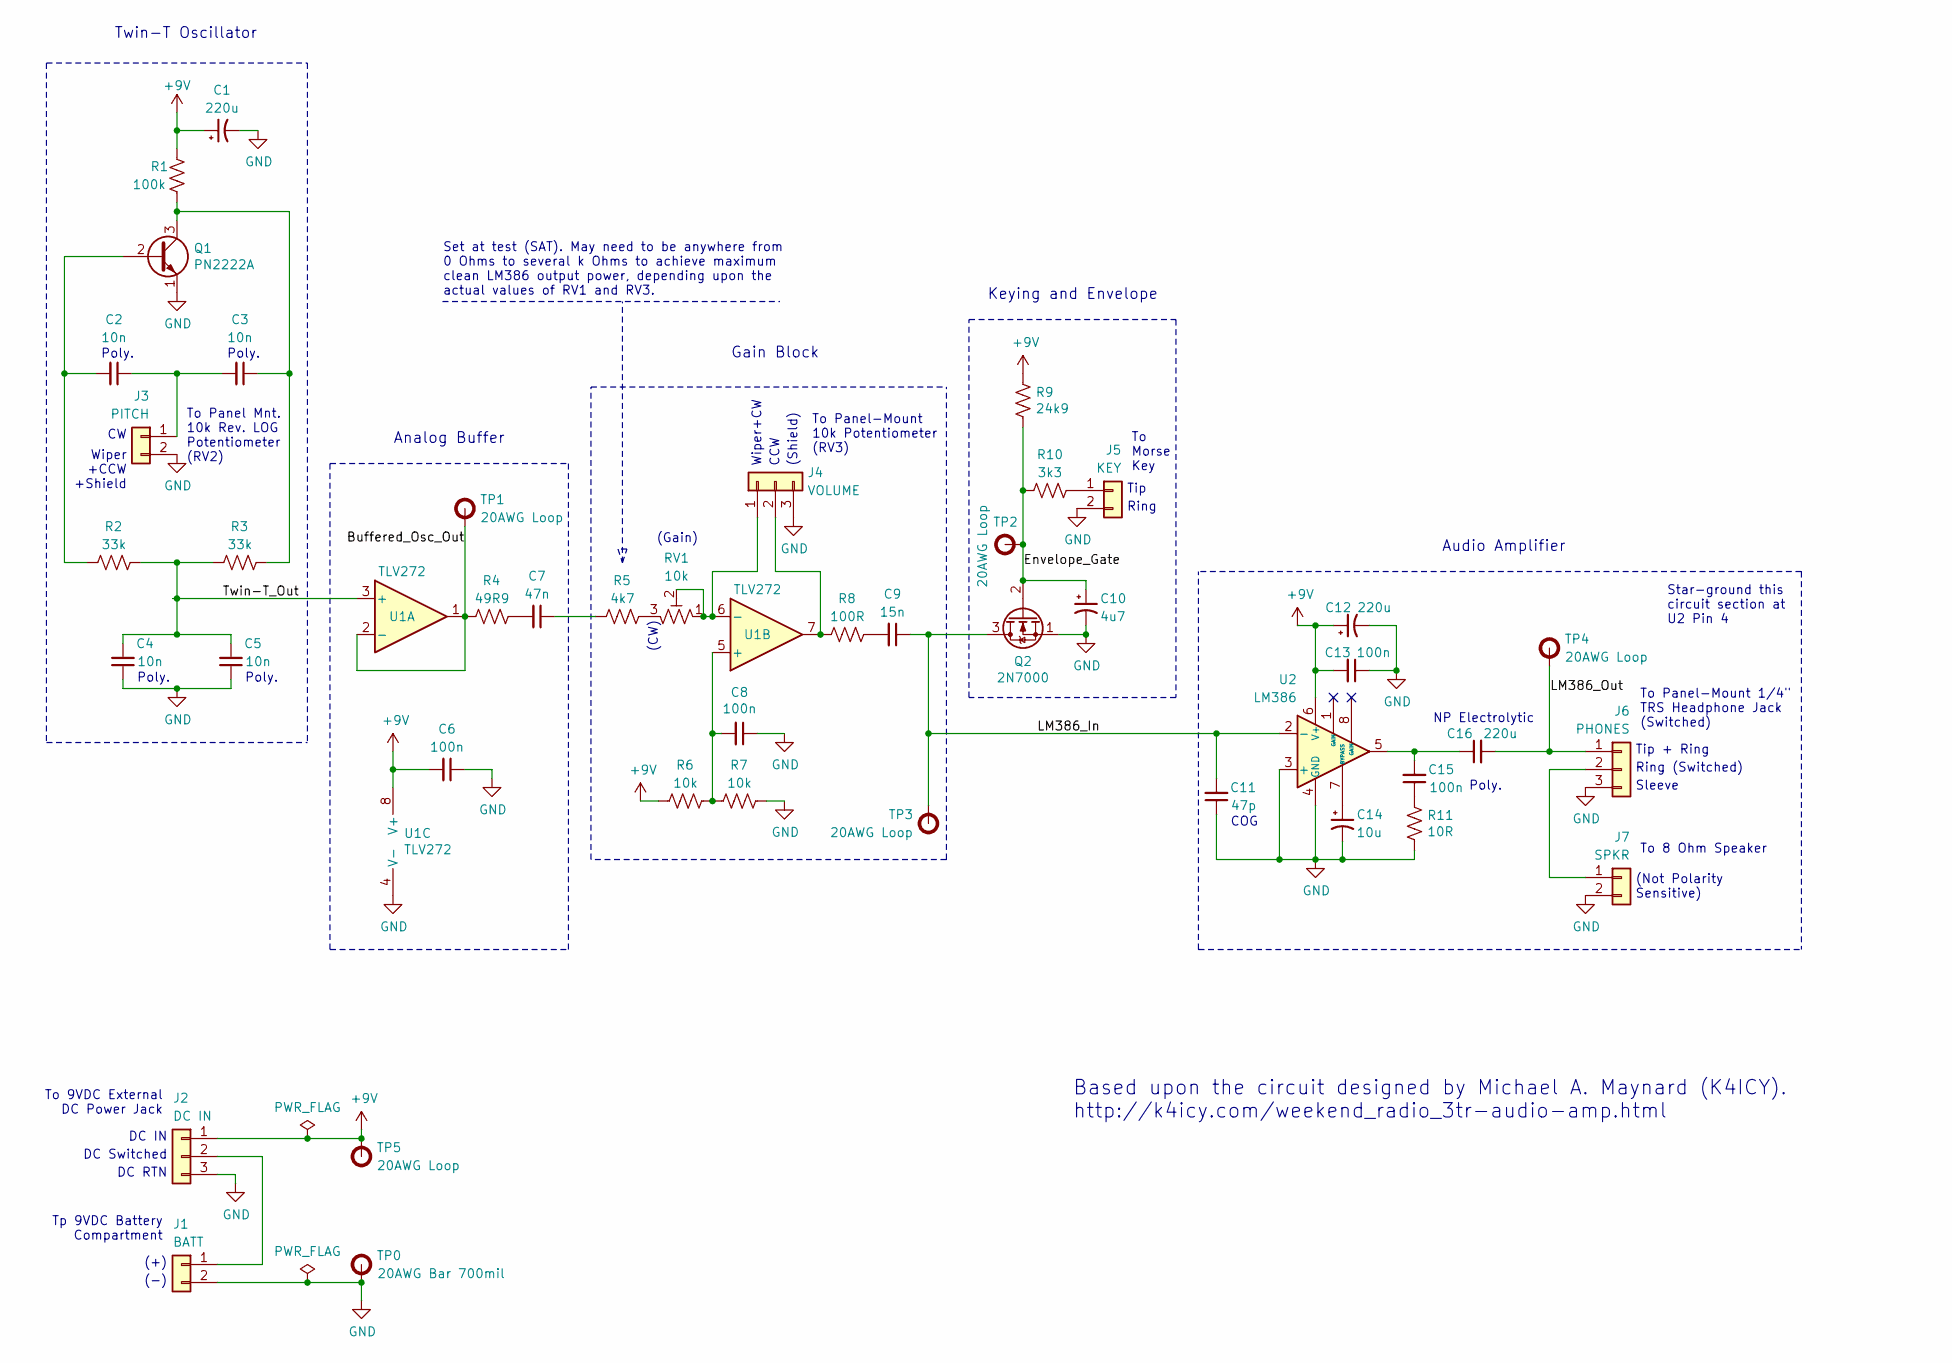
[picture p16: schematic Twin-T_Code_Practice_Oscillator.sch, Twin-T Morse Code Practice Oscillator]

Parts:
C1, C12: 220u; BE_Cap_Round_D6.3mm_H11.2mm_P2.5mm
C2, C3, C4, C5: 10n; BE_Cap_Rect-Film_W7.2mm_T2.5mm_H6.5mm_P5.0mm
C6, C8, C13: 100n; BE_Cap_MLCC_95milx150mil_P100mil
C7: 47n; BE_Cap_Rect-Film_W7.2mm_T2.5mm_H6.5mm_P5.0mm
C9: 15n; BE_Cap_Rect-Film_W7.2mm_T2.5mm_H6.5mm_P5.0mm
C10: 4u7; BE_Cap_Round_D3.0mm_P2.54mm
C11: 47p; BE_Cap_Dipped_W4.0mm_T2.6mm_H5.6mm_P2.5mm
C14: 10u; BE_Cap_Round_D4.0mm_H5.0mm_P2.54mm
C15: 100n; BE_Cap_Rect-Film_W7.2mm_T2.5mm_H6.5mm_P5.0mm
C16: 220u; BE_Cap_Round-NP_D10.0mm_H12.5mm_P5.0mm
J1: BATT; BE_Conn_HDR_SIP-2
J2: DC IN; BE_Conn_HDR_SIP-3
J3: PITCH; BE_Conn_HDR_SIP-2
J4: VOLUME; BE_Conn_HDR_SIP-3
J5: KEY; BE_Conn_HDR_SIP-2
J6: PHONES; BE_Conn_HDR_SIP-3
J7: SPKR; BE_Conn_HDR_SIP-2
Q1: PN2222A; TO92-3_Formed_Leads
Q2: 2N7000; TO92-3_Formed_Leads
R1: 100k; BE_Resistor_THT_Axial_.100x.400
R2, R3: 33k; BE_Resistor_THT_Axial_.100x.400
R4: 49R9; BE_Resistor_THT_Axial_.100x.400
R5: 4k7; BE_Resistor_THT_Axial_.100x.400
R6, R7: 10k; BE_Resistor_THT_Axial_.100x.400
R8: 100R; BE_Resistor_THT_Axial_.100x.400
R9: 24k9; BE_Resistor_THT_Axial_.100x.400
R10: 3k3; BE_Resistor_THT_Axial_.100x.400
R11: 10R; BE_Resistor_THT_Axial_.100x.400
RV1: 10k; Piher_PT6_Vertical
TP0: 20AWG Bar 700mil; BE_TP-Bar_20AWG_L700mil
TP1, TP2, TP3, TP4, TP5: 20AWG Loop; BE_TP-Loop_20AWG_D200MIL
U1: TLV272; BE_DIP-8_Socket
U2: LM386; BE_DIP-8_Socket

Connections:
+9V: C1.1, C6.2, C12.1, C13.2, J2.1, R1.2, R6.1, R9.1, TP5.1, U1.8 (V+), U2.6 (V+)
/Buffered_Osc_Out: R4.1, TP1.1, U1.1, U1.2 (-)
/Envelope_Gate: C10.1, Q2.2 (G), R9.2, R10.1, TP2.1
/LM386_In: C9.1, C11.2, Q2.3 (D), TP3.1, U2.2 (-)
/LM386_Out: C16.2, J6.1, TP4.1
/Twin-T_Out: C4.2, C5.2, R2.2, R3.1, U1.3 (+)
GND: C1.2, C4.1, C5.1, C6.1, C8.1, C10.2, C11.1, C12.2, C13.1, C14.2, J1.2, J2.3, J3.2, J4.3, J5.2, J6.3, J7.2, Q1.1 (E), Q2.1 (S), R7.2, R11.2, TP0.1, U1.4 (V-), U2.3 (+), U2.4 (GND)
unnamed: C2.1, C3.2, J3.1
unnamed: C2.2, Q1.2 (B), R2.1
unnamed: C3.1, Q1.3 (C), R1.1, R3.2
unnamed: C7.1, R5.1
unnamed: C7.2, R4.2
unnamed: C8.2, R6.2, R7.1, U1.5 (+)
unnamed: C9.2, R8.2
unnamed: C14.1, U2.7 (BYPASS)
unnamed: C15.1, R11.1
unnamed: C15.2, C16.1, U2.5
unnamed: J1.1, J2.2
unnamed: J4.1, RV1.1, RV1.2, U1.6 (-)
unnamed: J4.2, R8.1, U1.7
unnamed: J5.1, R10.2
unnamed: J6.2, J7.1
unnamed: R5.2, RV1.3

Notes on the sheet:
To Panel-Mount 1/4" TRS Headphone Jack (Switched)
Sleeve
Ring (Switched)
Tip + Ring
DC IN
DC Switched
DC RTN
To 9VDC External DC Power Jack
Tp 9VDC Battery Compartment
(+)
(-)
To 8 Ohm Speaker
Wiper +CCW +Shield
To Panel Mnt. 10k Rev. LOG Potentiometer (RV2)
To Panel-Mount 10k Potentiometer (RV3)
To Morse Key
NP Electrolytic
COG
Poly.
(Not Polarity Sensitive)
Based upon the circuit designed by Michael A. Maynard (K4ICY). http://k4icy.com/weekend_radio_3tr-audio-amp.html
Wiper+CW
CCW
(Gain)
(CW)
Twin-T Oscillator
Analog Buffer
Gain Block
Audio Amplifier
Tip
Ring
(Shield)
Star-ground this circuit section at U2 Pin 4
Keying and Envelope
Set at test (SAT). May need to be anywhere from 0 Ohms to several k Ohms to achieve maximum clean LM386 output power, depending upon the actual values of RV1 and RV3.

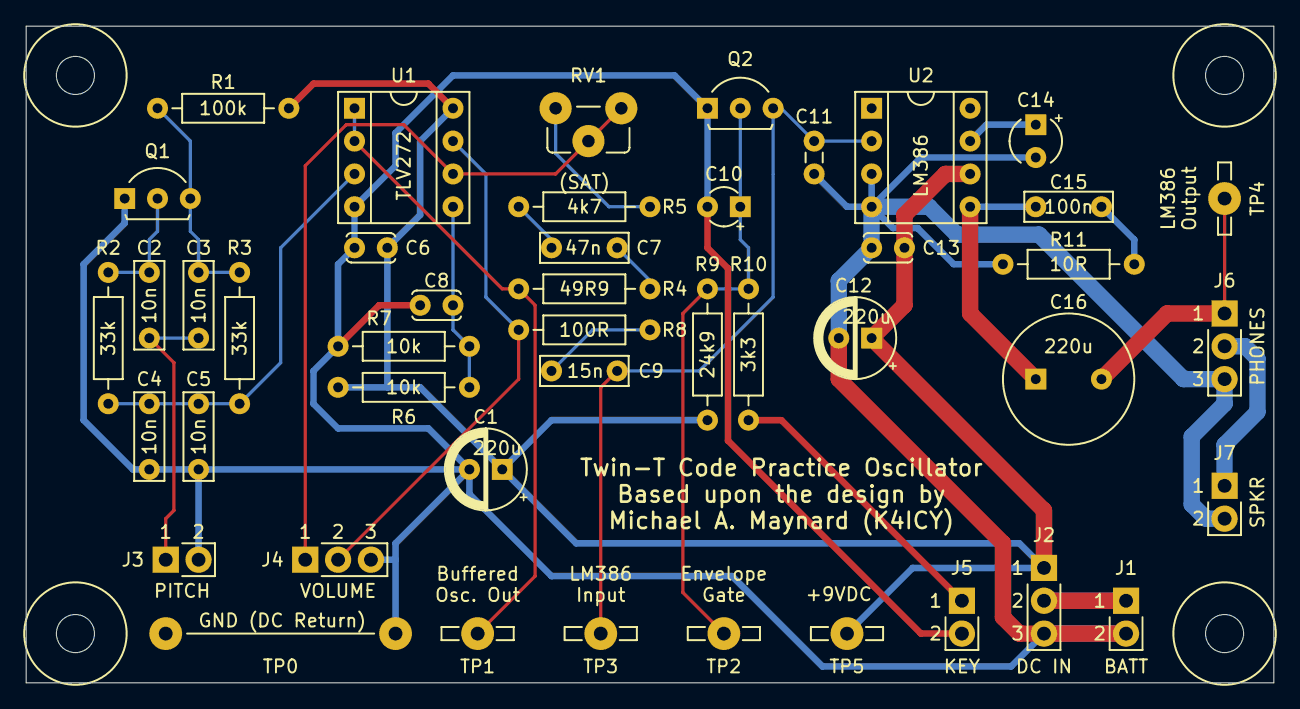
[picture p17: board Twin-T_Code_Practice_Oscillator.kicad_pcb from above]

Board: 2 copper layers, 96.5 x 50.8 mm, 49 parts (0 on the bottom side), 23 nets.

Other parts of the board:
MH1, MH2, MH3, MH4: BE_Nbr-4_Thru_Hole; BE_Nbr-4_Mounting_Hole
