JeffB-BE/Morse-CPO/(commit log)

2020-08-30 Initial commit of Rev(A)
    [Twin-T_Code_Practice_Oscillator-B_Cu.gbr, Twin-T_Code_Practice_Oscillator-B_Mask.gbr, Twin-T_Code_Practice_Oscillator-B_SilkS.gbr, Twin-T_Code_Practice_Oscillator-Edge_Cuts.gbr, Twin-T_Code_Practice_Oscillator-F_Cu.gbr, Twin-T_Code_Practice_Oscillator-F_Mask.gbr, Twin-T_Code_Practice_Oscillator-F_SilkS.gbr, Twin-T_Code_Practice_Oscillator-NPTH.drl]
2020-09-02 Swapped LM386 inputs, tweaked PCB layout, updated BOM
    [Twin-T_Code_Practice_Oscillator-B_Cu.gbr, Twin-T_Code_Practice_Oscillator-B_Mask.gbr, Twin-T_Code_Practice_Oscillator-B_SilkS.gbr, Twin-T_Code_Practice_Oscillator-Edge_Cuts.gbr, Twin-T_Code_Practice_Oscillator-F_Cu.gbr, Twin-T_Code_Practice_Oscillator-F_Mask.gbr, Twin-T_Code_Practice_Oscillator-F_SilkS.gbr, Twin-T_Code_Practice_Oscillator-NPTH.drl]
2020-09-02 Replaced RV1. Cleaned up all docs
    [Twin-T_Code_Practice_Oscillator-B_Cu.gbr, Twin-T_Code_Practice_Oscillator-B_Mask.gbr, Twin-T_Code_Practice_Oscillator-B_SilkS.gbr, Twin-T_Code_Practice_Oscillator-Edge_Cuts.gbr, Twin-T_Code_Practice_Oscillator-F_Cu.gbr, Twin-T_Code_Practice_Oscillator-F_Mask.gbr, Twin-T_Code_Practice_Oscillator-F_SilkS.gbr, Twin-T_Code_Practice_Oscillator-NPTH.drl]
